Danielm102/SPARK/README.md

# SPARK
Stepper Power And Regulation Kit
