Danielm102/SPARK/KiCAD/Manufacturing/SPARK_BOM.xlsx

Reference | Qty | Value | Footprint
C1,C11,C23 | 3 | 100u | Capacitor_THT:CP_Radial_D5.0mm_P2.00mm
C2,C3,C7,C8,C9,C10 | 6 | 22u | Capacitor_SMD:C_1206_3216Metric
C4,C5,C6,C16,C18,C20 | 6 | 100n | Capacitor_SMD:C_0402_1005Metric
C12 | 1 | 220u | Capacitor_THT:CP_Radial_D6.3mm_P2.50mm
C13 | 1 | 2u2 | Capacitor_SMD:C_0402_1005Metric
C14 | 1 | 1n5 | Capacitor_SMD:C_0402_1005Metric
C15 | 1 | 12p | Capacitor_SMD:C_0402_1005Metric
C17 | 1 | 10u | Capacitor_SMD:C_0805_2012Metric
C19 | 1 | 220n | Capacitor_SMD:C_0402_1005Metric
C21,C22 | 2 | 10n | Capacitor_SMD:C_0402_1005Metric
C24 | 1 | 22n | Capacitor_SMD:C_0402_1005Metric
C25 | 1 | 1u | Capacitor_SMD:C_0603_1608Metric
J1,J2 | 2 | SM02B-GHS-TB | Connector_JST:JST_GH_SM02B-GHS-TB_1x02-1MP_P1.25mm_Horizontal
J3 | 1 | JST-XH-B4B | Connector_JST:JST_XH_B4B-XH-A_1x04_P2.50mm_Vertical
J4 | 1 | MicroFit | Connector_Molex:Molex_Micro-Fit_3.0_43045-0410_2x02-1MP_P3.00mm_Horizontal
J5 | 1 | SM06B-GHS-TB | Connector_JST:JST_GH_SM06B-GHS-TB_1x06-1MP_P1.25mm_Horizontal
J7,J8 | 2 | SM04B-GHS-TB | Connector_JST:JST_GH_SM04B-GHS-TB_1x04-1MP_P1.25mm_Horizontal
L1 | 1 | 2u2 | Library:L_13.5x12.8
LED1 | 1 | WS2812B | LED_SMD:LED_WS2812B_PLCC4_5.0x5.0mm_P3.2mm
LED2 | 1 | RED | LED_SMD:LED_0603_1608Metric
LED3 | 1 | YELLOW | LED_SMD:LED_0603_1608Metric
LED4,LED5 | 2 | GREEN | LED_SMD:LED_0603_1608Metric
LED6,LED7 | 2 | BLUE | LED_SMD:LED_0603_1608Metric
R1,R3 | 2 | 82k | Resistor_SMD:R_0402_1005Metric
R2 | 1 | 4k3 | Resistor_SMD:R_0402_1005Metric
R4,R5,R6,R14 | 4 | 10k | Resistor_SMD:R_0402_1005Metric
R7 | 1 | 2k2 | Resistor_SMD:R_0402_1005Metric
R8,R10,R11,R12,R13 | 5 | 1k | Resistor_SMD:R_0402_1005Metric
R9 | 1 | 4k7 | Resistor_SMD:R_0402_1005Metric
R15 | 1 | 14k7 | Resistor_SMD:R_0402_1005Metric
R16 | 1 | 2k8 | Resistor_SMD:R_0402_1005Metric
SW1 | 1 | SW_SPST | Button_Switch_SMD:Panasonic_EVQPUL_EVQPUC
TH1,TH2 | 2 | 10k | Resistor_SMD:R_0603_1608Metric
U1 | 1 | TPS61288RQQR | Package_DFN_QFN:Texas_VQFN-HR-20_3x2.5mm_P0.5mm_RQQ0011A
U2 | 1 | STM32G071KBT6 | Package_QFP:LQFP-32_7x7mm_P0.8mm
U3 | 1 | DRV8434S | Library:HTSSOP-28-1EP_4.4x9.7mm_P0.65mm_EP3.1x4.05mm_ThermalVias
