Danielm102/SPARK/KiCAD/SPARK_Schematic.pdf

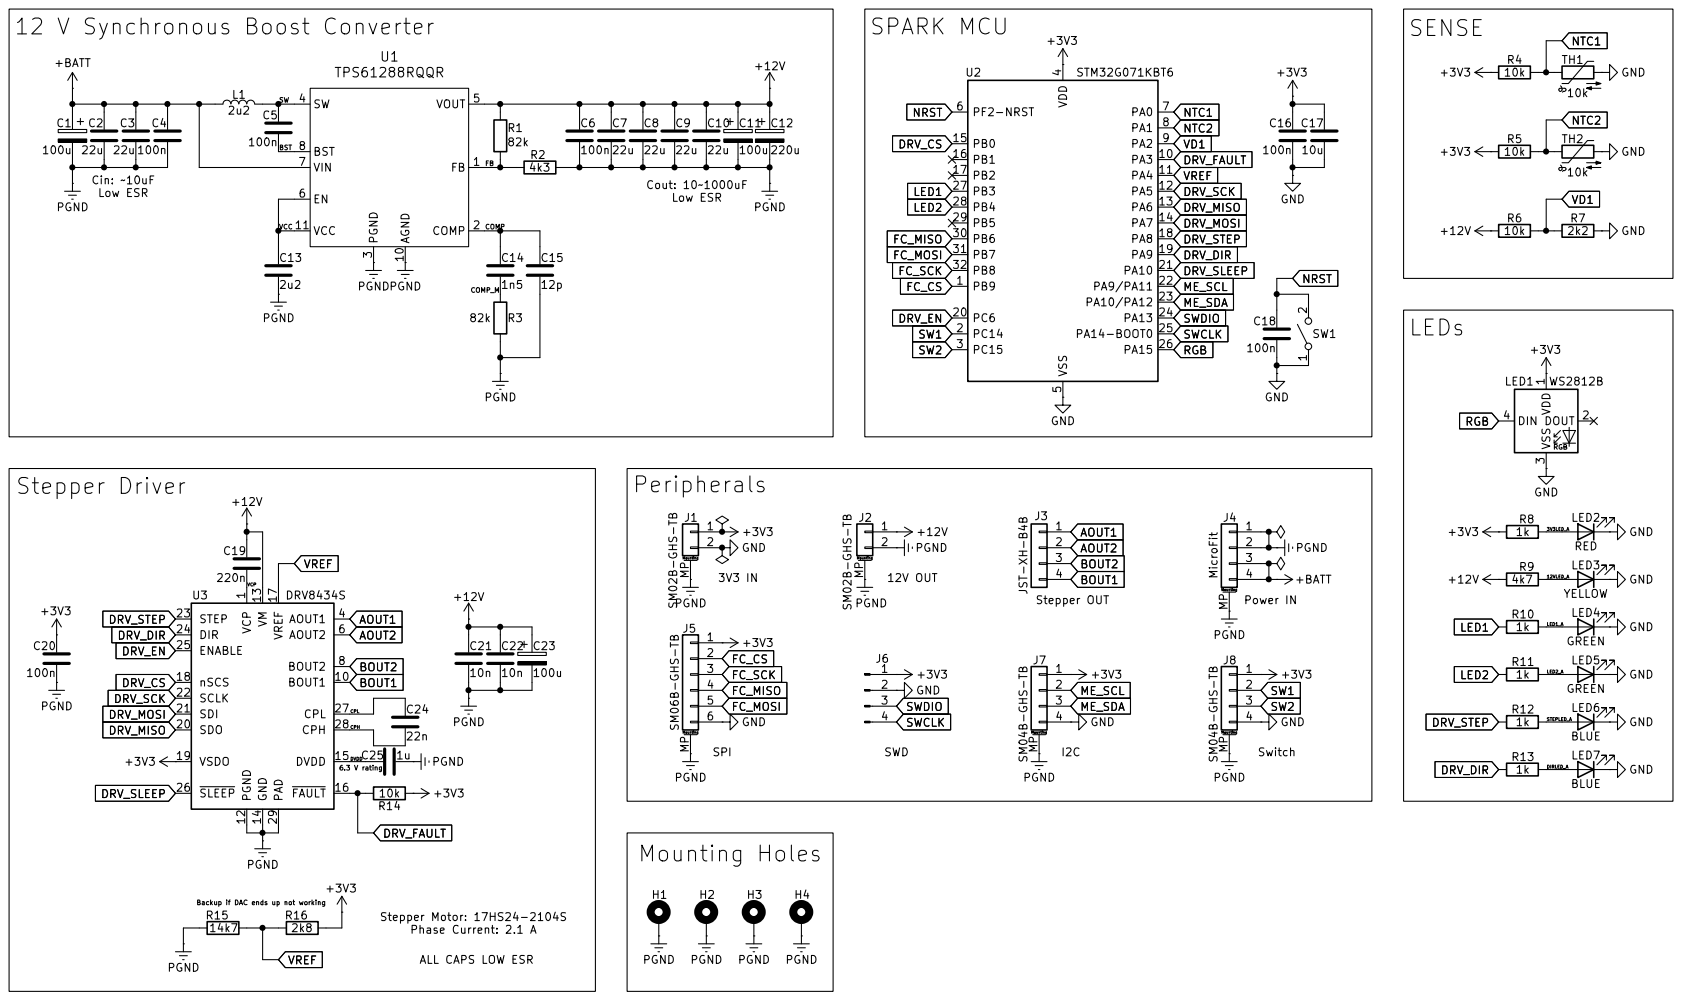
[picture p1: page 1]
