Danielm102/SPARK/KiCAD/SPARK.kicad_pcb

## KiCad design KiCAD/SPARK.kicad_pcb (2025-09-06)

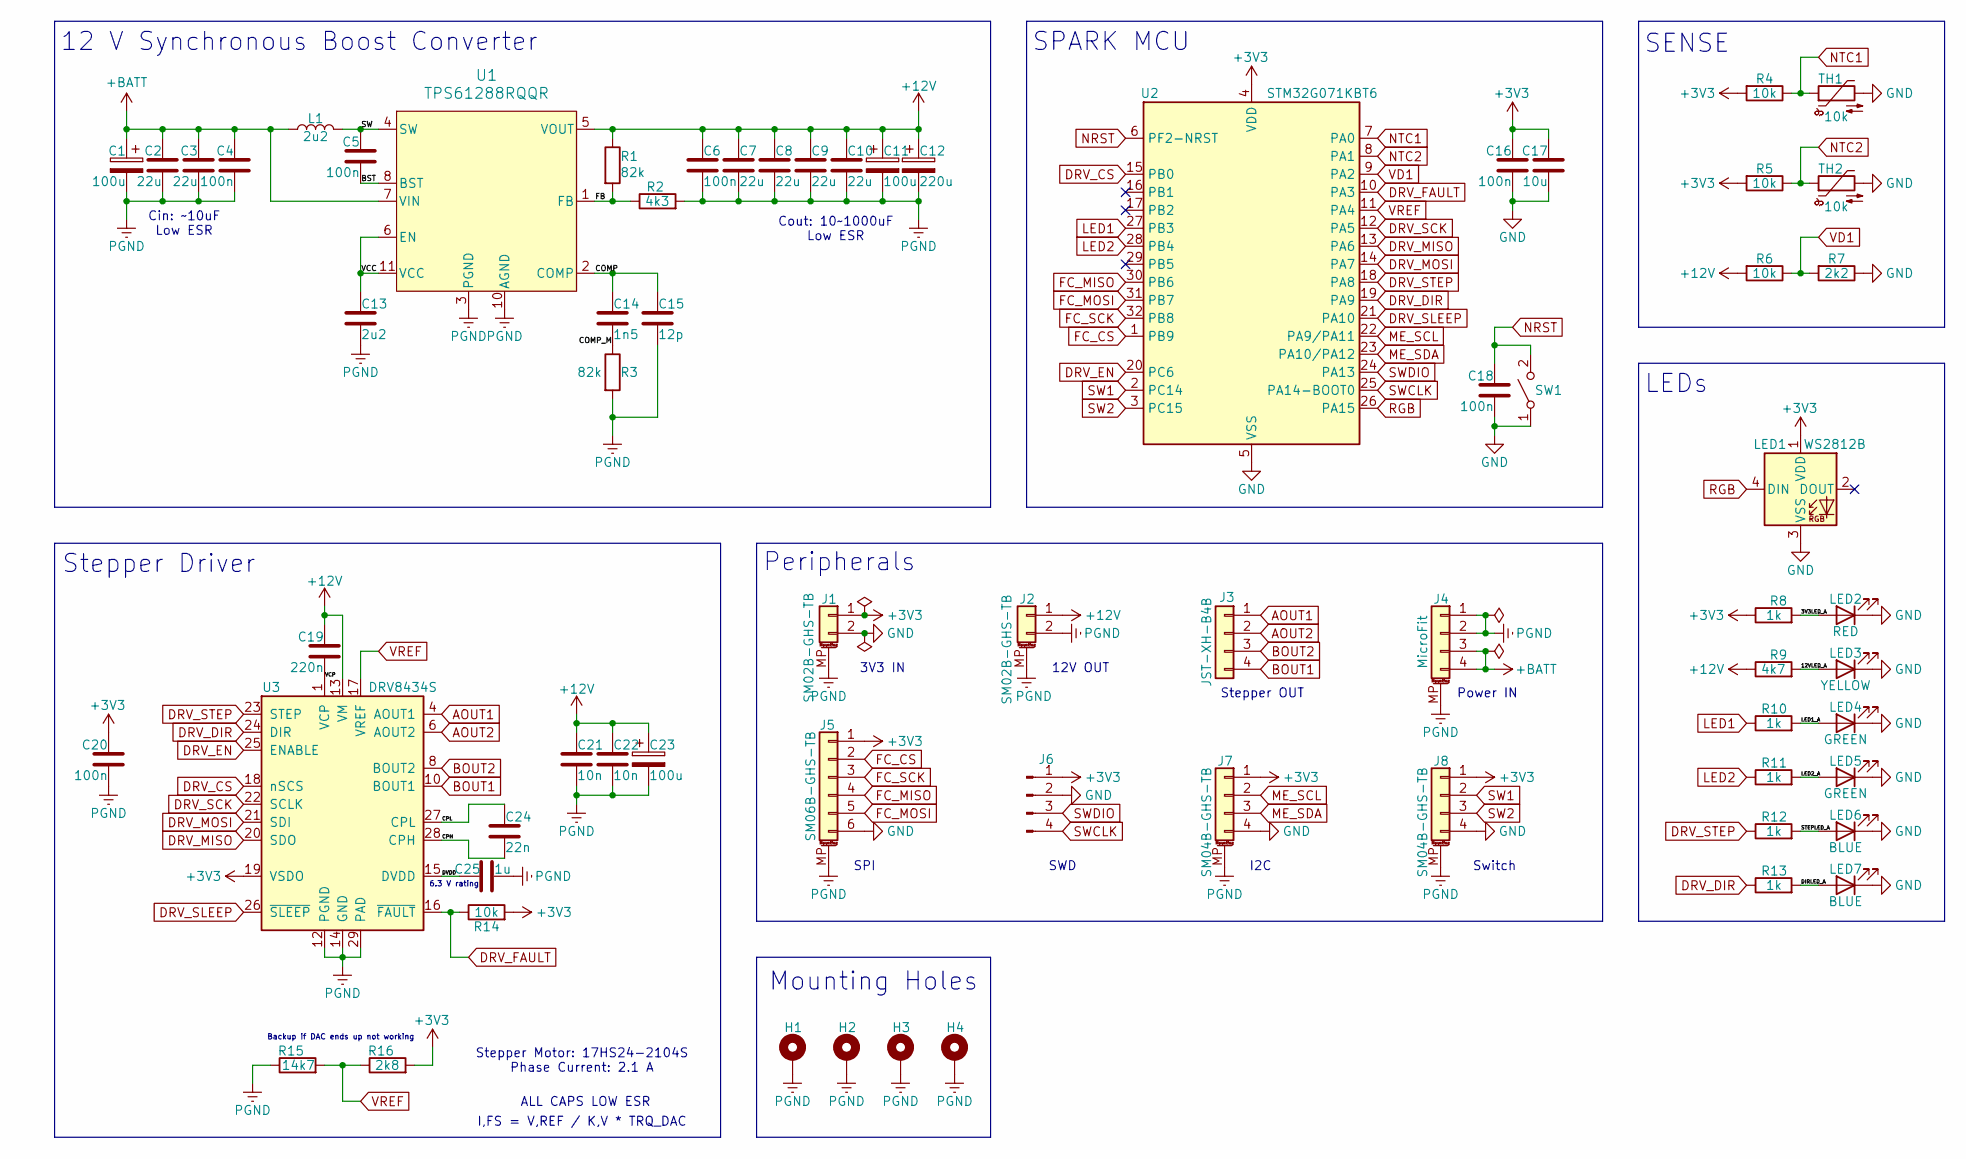
[picture p2: schematic SPARK.kicad_sch]

Parts:
C1, C11, C23: 100u; CP_Radial_D5.0mm_P2.00mm
C2, C3, C7, C8, C9, C10: 22u; C_1206_3216Metric
C4, C5, C6, C16, C18, C20: 100n; C_0402_1005Metric
C12: 220u; CP_Radial_D6.3mm_P2.50mm
C13: 2u2; C_0402_1005Metric
C14: 1n5; C_0402_1005Metric
C15: 12p; C_0402_1005Metric
C17: 10u; C_0805_2012Metric
C19: 220n; C_0402_1005Metric
C21, C22: 10n; C_0402_1005Metric
C24: 22n; C_0402_1005Metric
C25: 1u; C_0603_1608Metric
H1, H2, H3, H4: MountingHole_Pad; MountingHole_2.2mm_M2_Pad_Via
J1, J2: SM02B-GHS-TB; JST_GH_SM02B-GHS-TB_1x02-1MP_P1.25mm_Horizontal
J3: JST-XH-B4B; JST_XH_B4B-XH-A_1x04_P2.50mm_Vertical
J4: MicroFit; Molex_Micro-Fit_3.0_43045-0410_2x02-1MP_P3.00mm_Horizontal
J5: SM06B-GHS-TB; JST_GH_SM06B-GHS-TB_1x06-1MP_P1.25mm_Horizontal
J6: Conn_01x04_Pin; PinHeader_1x04_P2.54mm_Vertical
J7, J8: SM04B-GHS-TB; JST_GH_SM04B-GHS-TB_1x04-1MP_P1.25mm_Horizontal
L1: 2u2; L_13.5x12.8
LED1: WS2812B; LED_WS2812B_PLCC4_5.0x5.0mm_P3.2mm
LED2: RED; LED_0603_1608Metric
LED3: YELLOW; LED_0603_1608Metric
LED4, LED5: GREEN; LED_0603_1608Metric
LED6, LED7: BLUE; LED_0603_1608Metric
R1, R3: 82k; R_0402_1005Metric
R2: 4k3; R_0402_1005Metric
R4, R5, R6, R14: 10k; R_0402_1005Metric
R7: 2k2; R_0402_1005Metric
R8, R10, R11, R12, R13: 1k; R_0402_1005Metric
R9: 4k7; R_0402_1005Metric
R15: 14k7; R_0402_1005Metric
R16: 2k8; R_0402_1005Metric
SW1: SW_SPST; Panasonic_EVQPUL_EVQPUC
TH1, TH2: 10k; R_0603_1608Metric
U1: TPS61288RQQR; Texas_VQFN-HR-20_3x2.5mm_P0.5mm_RQQ0011A
U2: STM32G071KBT6; LQFP-32_7x7mm_P0.8mm
U3: DRV8434S; HTSSOP-28-1EP_4.4x9.7mm_P0.65mm_EP3.1x4.05mm_ThermalVias

Connections:
+3V3: C16.1, C17.1, C20.1, J1.1, J5.1, J6.1, J7.1, J8.1, LED1.1 (VDD), R4.2, R5.2, R8.1, R14.2, R16.2, U2.4 (VDD), U3.19 (VSDO)
+12V: C6.1, C7.1, C8.1, C9.1, C10.1, C11.1, C12.1, C19.1, C21.1, C22.1, C23.1, J2.1, R1.1, R6.2, R9.1, U1.5 (VOUT), U3.2 (VM), U3.13 (VM)
+BATT: C1.1, C2.1, C3.1, C4.1, J4.3, J4.4, L1.1, U1.7 (VIN)
/3V3LED_A: LED2.2 (A), R8.2
/12VLED_A: LED3.2 (A), R9.2
/BST: C5.2, U1.8 (BST)
/COMP: C14.1, C15.1, U1.2 (COMP)
/COMP_M: C14.2, R3.1
/CPH: C24.2, U3.28 (CPH)
/CPL: C24.1, U3.27 (CPL)
/DIRLED_A: LED7.2 (A), R13.2
/DVDD: C25.1, U3.15 (DVDD)
/FB: R1.2, R2.1, U1.1 (FB)
/LED1_A: LED4.2 (A), R10.2
/LED2_A: LED5.2 (A), R11.2
/STEPLED_A: LED6.2 (A), R12.2
/SW: C5.1, L1.2, U1.4 (SW), U1.9 (SW)
/VCC: C13.1, U1.6 (EN), U1.11 (VCC)
/VCP: C19.2, U3.1 (VCP)
AOUT1: J3.1, U3.4 (AOUT1), U3.5 (AOUT1)
AOUT2: J3.2, U3.6 (AOUT2), U3.7 (AOUT2)
BOUT1: J3.4, U3.10 (BOUT1), U3.11 (BOUT1)
BOUT2: J3.3, U3.8 (BOUT2), U3.9 (BOUT2)
DRV_CS: U2.15 (PB0), U3.18 (nSCS)
DRV_DIR: R13.1, U2.19 (PA9), U3.24 (DIR)
DRV_EN: U2.20 (PC6), U3.25 (ENABLE)
DRV_FAULT: R14.1, U2.10 (PA3), U3.16 (~FAULT)
DRV_MISO: U2.13 (PA6), U3.20 (SDO)
DRV_MOSI: U2.14 (PA7), U3.21 (SDI)
DRV_SCK: U2.12 (PA5), U3.22 (SCLK)
DRV_SLEEP: U2.21 (PA10), U3.26 (~SLEEP)
DRV_STEP: R12.1, U2.18 (PA8), U3.23 (STEP)
FC_CS: J5.2, U2.1 (PB9)
FC_MISO: J5.4, U2.30 (PB6)
FC_MOSI: J5.5, U2.31 (PB7)
FC_SCK: J5.3, U2.32 (PB8)
GND: C16.2, C17.2, C18.2, J1.2, J5.6, J6.2, J7.4, J8.4, LED1.3 (VSS), LED2.1 (K), LED3.1 (K), LED4.1 (K), LED5.1 (K), LED6.1 (K), LED7.1 (K), R7.1, SW1.1 (A), TH1.2, TH2.2, U2.5 (VSS)
LED1: R10.1, U2.27 (PB3)
LED2: R11.1, U2.28 (PB4)
ME_SCL: J7.2, U2.22 (PA9/PA11)
ME_SDA: J7.3, U2.23 (PA10/PA12)
NRST: C18.1, SW1.2 (B), U2.6 (PF2-NRST)
NTC1: R4.1, TH1.1, U2.7 (PA0)
NTC2: R5.1, TH2.1, U2.8 (PA1)
PGND: C1.2, C2.2, C3.2, C4.2, C6.2, C7.2, C8.2, C9.2, C10.2, C11.2, C12.2, C13.2, C15.2, C20.2, C21.2, C22.2, C23.2, C25.2, H1.1, H2.1, H3.1, H4.1, J1.MP (MountPin), J2.2, J2.MP (MountPin), J4.1, J4.2, J4.MP (MountPin), J5.MP (MountPin), J7.MP (MountPin), J8.MP (MountPin), R2.2, R3.2, R15.1, U1.3 (PGND), U1.10 (AGND), U3.3 (PGND), U3.12 (PGND), U3.14 (GND), U3.29 (PAD)
RGB: LED1.4 (DIN), U2.26 (PA15)
SW1: J8.2, U2.2 (PC14)
SW2: J8.3, U2.3 (PC15)
SWCLK: J6.4, U2.25 (PA14-BOOT0)
SWDIO: J6.3, U2.24 (PA13)
VD1: R6.1, R7.2, U2.9 (PA2)
VREF: R15.2, R16.1, U2.11 (PA4), U3.17 (VREF)

Notes on the sheet:
Peripherals
ALL CAPS LOW ESR
Stepper OUT
Mounting Holes
I,FS = V,REF / K,V * TRQ_DAC
3V3 IN
Power IN
I2C
SENSE
12V OUT
Cin: ~10uF Low ESR
SPI
SWD
SPARK MCU
Stepper Driver
LEDs
6.3 V rating
Stepper Motor: 17HS24-2104S Phase Current: 2.1 A
12 V Synchronous Boost Converter
Cout: 10~1000uF Low ESR
Switch
Backup if DAC ends up not working

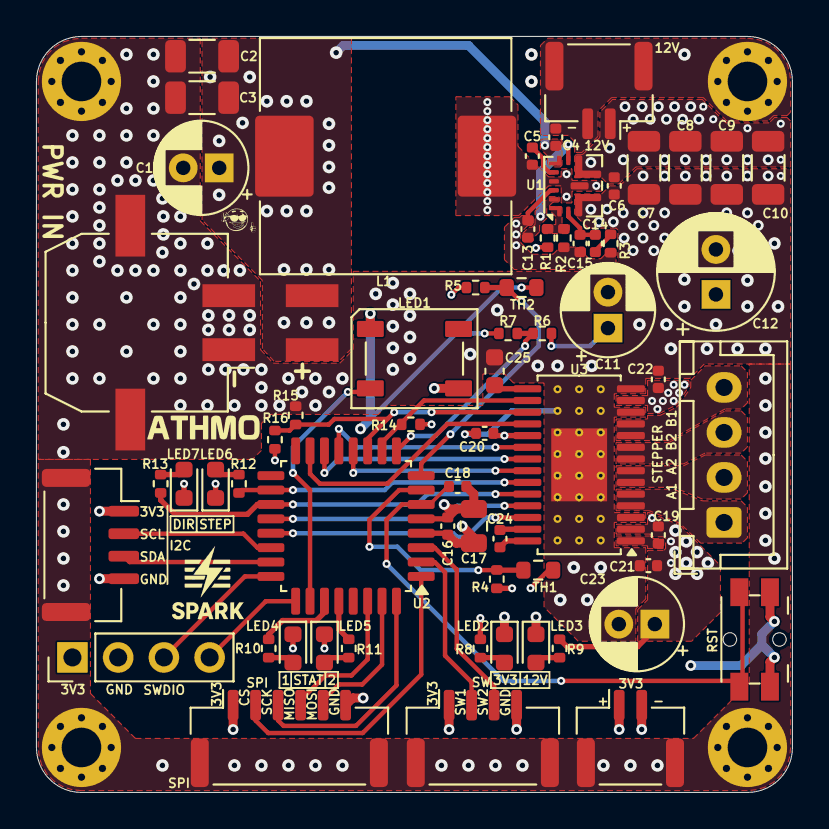
[picture p3: board SPARK.kicad_pcb from above]

Board: 4 copper layers, 42.0 x 42.0 mm, 67 parts (0 on the bottom side), 52 nets.
