Danielm102/SPARK/Core/Src/main.c

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
/* Includes ------------------------------------------------------------------*/
#include "main.h"

ADC_HandleTypeDef hadc1;

DAC_HandleTypeDef hdac1;

I2C_HandleTypeDef hi2c2;

SPI_HandleTypeDef hspi1;
SPI_HandleTypeDef hspi2;

TIM_HandleTypeDef htim1;
TIM_HandleTypeDef htim2;
TIM_HandleTypeDef htim3;
TIM_HandleTypeDef htim7;
DMA_HandleTypeDef hdma_tim1_ch1;
DMA_HandleTypeDef hdma_tim2_ch1;

/* USER CODE BEGIN PV */
volatile uint32_t tim7_ms = 0;
uint32_t tim7_target_ms;

uint16_t tick_ks = 0;
uint32_t tick_ms = 0;
uint32_t tick_us = 0;
uint32_t tick_raw = 0;
uint32_t tick_us_start = 0;
uint16_t overflow_count = 0;

uint32_t dt_100Hz;
uint32_t dt_10Hz;

uint32_t loop_counter_100Hz = 0;
uint32_t loop_counter_10Hz = 0;

volatile uint8_t dma_waiting_ws2812;

AS5600_status_t AS5600_status;

float voltage_driver;
float temperature_driver;
float temperature_converter;

float mag_angle = 0;
float mag_speed = 0;
float rotation_count = 0;
float mag_angle_continuous = 0;
float angle_cmd_prev = 0;
float angle_cmd_diff = 0;

/* USER CODE END PV */

void SystemClock_Config(void);
static void MX_GPIO_Init(void);
static void MX_DMA_Init(void);
static void MX_SPI1_Init(void);
static void MX_TIM1_Init(void);
static void MX_I2C2_Init(void);
static void MX_SPI2_Init(void);
static void MX_ADC1_Init(void);
static void MX_DAC1_Init(void);
static void MX_TIM2_Init(void);
static void MX_TIM3_Init(void);
static void MX_TIM7_Init(void);
/**
  * @brief  The application entry point.
  * @retval int
  */
int main(void)
{

  /* MCU Configuration--------------------------------------------------------*/

  /* Reset of all peripherals, Initializes the Flash interface and the Systick. */
  HAL_Init();

  /* Configure the system clock */
  SystemClock_Config();

  /* Initialize all configured peripherals */
  MX_GPIO_Init();
  MX_DMA_Init();
  MX_SPI1_Init();
  MX_TIM1_Init();
  MX_I2C2_Init();
  MX_SPI2_Init();
  MX_ADC1_Init();
  MX_DAC1_Init();
  MX_TIM2_Init();
  MX_TIM3_Init();
  MX_TIM7_Init();
  /* USER CODE BEGIN 2 */
  
  RunOnce();
  /* USER CODE END 2 */

  /* Infinite loop */
  /* USER CODE BEGIN WHILE */
  while (1)
  {
    HAL_GetTickUS();

    if(tick_us > 10000 * loop_counter_100Hz - TICK_US_RESET_THRESHOLD * tick_ks) {
      TimeMeasureStart();
      loop_counter_100Hz++;
      Loop_100Hz();
      dt_100Hz = TimeMeasureStop();
    }
    
    if(tick_us > 100000 * loop_counter_10Hz - TICK_US_RESET_THRESHOLD * tick_ks) {
      TimeMeasureStart();
      loop_counter_10Hz++;
      Loop_10Hz();
      dt_10Hz = TimeMeasureStop();
    }
  }
  /* USER CODE END 3 */
}

void RunOnce() 
{
  Stepper_Sleep();
  HAL_Delay(100);
  StateMachine_Init(&spark_sm, STATE_STARTUP);

  AS5600_readAngle(&mag_angle_continuous);

  Communication_ActivateReceive();

  angle_cmd_prev = stepper.pos_cmd;
}

void Loop_100Hz()
{
  AS5600_readAngle(&mag_angle);
  AngleConstrainedToContinuous(mag_angle, &mag_angle_continuous, &rotation_count);

  mag_speed = (mag_angle_continuous - stepper.pos_prev) * 100.f;
  angle_cmd_diff = ((stepper.pos_cmd - angle_cmd_prev) * 100.f) * 0.1f + angle_cmd_diff * 0.9f;
  angle_cmd_prev = stepper.pos_cmd;

  StateMachine_DoActions(&spark_sm, 100);
  Stepper_getFullStatus();
  if (DRV_status.FAULT) {
    Stepper_clearFaults();
  }
  Stepper_updateSpeed(100, mag_angle_continuous);

  ShowStatus(RGB_LED, spark_sm.currentState, 1, 100);
}

void Loop_10Hz()
{ 
  temperature_driver = readTemperature(ADC_CHANNEL_0);
  temperature_converter = readTemperature(ADC_CHANNEL_1);
  voltage_driver = readVoltage(ADC_CHANNEL_2) * 12.2f / 2.2f;

  StateMachine_DoActions(&spark_sm, 10);

  AS5600_getStatus(&AS5600_status);
}

void HAL_GPIO_EXTI_Rising_Callback(uint16_t GPIO_Pin) {
  // handle DRV8434S fault release
  if(GPIO_Pin == DRV_FAULT_Pin) {
    HAL_GPIO_WritePin(LED2_GPIO_Port, LED2_Pin, GPIO_PIN_SET);
  }
}

void HAL_GPIO_EXTI_Falling_Callback(uint16_t GPIO_Pin) {
  // handle DRV8434S fault detection
  if(GPIO_Pin == DRV_FAULT_Pin) {
    HAL_GPIO_WritePin(LED2_GPIO_Port, LED2_Pin, GPIO_PIN_RESET);

    Stepper_getFullStatus();

    if (DRV_status.STL) {
      stepper.stall_count++;
      StateMachine_Dispatch(&spark_sm, EVENT_STEPPER_STALLED);
    }
    if (DRV_status.UVLO) StateMachine_Dispatch(&spark_sm, EVENT_UVLO);
    if (DRV_status.TF) StateMachine_Dispatch(&spark_sm, EVENT_DRIVER_OVERHEAT);
  } else if(GPIO_Pin == FC_CS_Pin) {
    // handle falling edge of SPI1 chip select - start of new command packet
    //Communication_ActivateReceive();
  }
}

void HAL_SPI_TxRxCpltCallback(SPI_HandleTypeDef *hspi) {
  if(hspi->Instance == SPI2) {
    // Process received data
    ProcessCommandPacket();
    UpdateSPARKDataPacket(&spark_data_packet, mag_angle_continuous - stepper.neutral_angle, angle_cmd_diff, mag_angle_continuous - stepper.pos_cmd, voltage_driver, temperature_driver, temperature_converter, (uint8_t)spark_sm.currentState);
    spi2_tx_buffer[31] = getCRC(&spark_data_packet);
    Communication_ActivateReceive();
  }
}

void HAL_SPI_ErrorCallback(SPI_HandleTypeDef *hspi) {
  if(hspi->Instance == SPI2) {
    // Handle SPI error
    Communication_ActivateReceive();
  }
}

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
/* USER CODE BEGIN 4 */
void HAL_TIM_PWM_PulseFinishedCallback(TIM_HandleTypeDef *htim)
{
  if (htim->Instance == TIM1 && htim->Channel == HAL_TIM_ACTIVE_CHANNEL_1) {
    HAL_TIM_PWM_Stop_DMA(&htim1, TIM_CHANNEL_1);
    Stepper_Disable();
  }
  if (htim->Instance == TIM2 && htim->Channel == HAL_TIM_ACTIVE_CHANNEL_1) {
    HAL_TIM_PWM_Stop_DMA(&htim2, TIM_CHANNEL_1);
    dma_waiting_ws2812 = 0;
    led_skip_counter = 0;
  }
}

void HAL_TIM_PeriodElapsedCallback(TIM_HandleTypeDef *htim)
{
  if (htim->Instance == TIM1 && htim->Channel == HAL_TIM_ACTIVE_CHANNEL_1) {
    // PWM burst finished
    HAL_TIM_PWM_Stop(htim, TIM_CHANNEL_1);
  }
  else if (htim->Instance == TIM7) {
    tim7_ms++;
    if (tim7_ms >= tim7_target_ms) {
      tim7_ms = 0;
      HAL_TIM_Base_Stop_IT(&htim7);
      
      StateMachine_Dispatch(&spark_sm, EVENT_TIMER_ELAPSED);
    }
  }
}

uint32_t HAL_GetTickUS(void) {
  uint32_t tick_now = TIM3->CNT;
  if (tick_now < tick_raw)
    overflow_count++;

  tick_raw = tick_now;
  tick_us = tick_raw + overflow_count * 65536;
  if (tick_us > TICK_US_RESET_THRESHOLD) {
    tick_ks++;
    overflow_count = 0;
  }

  return tick_us; // get the current value of TIM3 counter
}

void TimeMeasureStart(void) {
  tick_us_start = HAL_GetTickUS();
}

uint32_t TimeMeasureStop(void) {
  int32_t time_diff = HAL_GetTickUS() - tick_us_start;
  if (time_diff < 0)
    time_diff += TICK_US_RESET_THRESHOLD;
  return time_diff;
}
/* USER CODE END 4 */
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
