Danielm102/SPARK/SPARK.ioc

Mcu.UserName=STM32G071KBTx
PA0.GPIO_Label=NTC1
PA0.Signal=ADC1_IN0
PA1.GPIO_Label=NTC2
PA1.Signal=ADC1_IN1
PA10.GPIO_Label=DRV_SLEEP
PA10.Signal=GPIO_Output
PA13.Signal=SYS_SWDIO
PA14-BOOT0.Signal=SYS_SWCLK
PA15.GPIO_Label=RGB
PA15.Signal=S_TIM2_CH1_ETR
PA2.GPIO_Label=VD1
PA2.Signal=ADC1_IN2
PA3.GPIO_Label=DRV_FAULT
PA3.Signal=GPXTI3
PA4.GPIO_Label=DRV_VREF
PA4.Signal=COMP_DAC11_group
PA5.Signal=SPI1_SCK
PA6.Signal=SPI1_MISO
PA7.Signal=SPI1_MOSI
PA8.GPIO_Label=DRV_STEP
PA8.Signal=S_TIM1_CH1
PA9.GPIO_Label=DRV_DIR
PA9.Signal=GPIO_Output
PB0.GPIO_Label=DRV_CS
PB0.Signal=GPIO_Output
PB3.GPIO_Label=LED1
PB3.Signal=GPIO_Output
PB4.GPIO_Label=LED2
PB4.Signal=GPIO_Output
PB6.GPIO_Label=FC_MISO
PB6.Signal=SPI2_MISO
PB7.GPIO_Label=FC_MOSI
PB7.Signal=SPI2_MOSI
PB8.GPIO_Label=FC_SCK
PB8.Signal=SPI2_SCK
PB9.GPIO_Label=FC_CS
PB9.Signal=GPXTI9
PC6.GPIO_Label=DRV_EN
PC6.Signal=GPIO_Output
