Danielm102/SPARK/Core/Inc/main.h

#define FC_CS_Pin GPIO_PIN_9
#define FC_CS_GPIO_Port GPIOB
#define FC_CS_EXTI_IRQn EXTI4_15_IRQn
#define SW1_Pin GPIO_PIN_14
#define SW1_GPIO_Port GPIOC
#define SW1_EXTI_IRQn EXTI4_15_IRQn
#define SW2_Pin GPIO_PIN_15
#define SW2_GPIO_Port GPIOC
#define SW2_EXTI_IRQn EXTI4_15_IRQn
#define NTC1_Pin GPIO_PIN_0
#define NTC1_GPIO_Port GPIOA
#define NTC2_Pin GPIO_PIN_1
#define NTC2_GPIO_Port GPIOA
#define VD1_Pin GPIO_PIN_2
#define VD1_GPIO_Port GPIOA
#define DRV_FAULT_Pin GPIO_PIN_3
#define DRV_FAULT_GPIO_Port GPIOA
#define DRV_FAULT_EXTI_IRQn EXTI2_3_IRQn
#define DRV_VREF_Pin GPIO_PIN_4
#define DRV_VREF_GPIO_Port GPIOA
#define DRV_CS_Pin GPIO_PIN_0
#define DRV_CS_GPIO_Port GPIOB
#define DRV_STEP_Pin GPIO_PIN_8
#define DRV_STEP_GPIO_Port GPIOA
#define DRV_DIR_Pin GPIO_PIN_9
#define DRV_DIR_GPIO_Port GPIOA
#define DRV_EN_Pin GPIO_PIN_6
#define DRV_EN_GPIO_Port GPIOC
#define DRV_SLEEP_Pin GPIO_PIN_10
#define DRV_SLEEP_GPIO_Port GPIOA
#define RGB_Pin GPIO_PIN_15
#define RGB_GPIO_Port GPIOA
#define LED1_Pin GPIO_PIN_3
#define LED1_GPIO_Port GPIOB
#define LED2_Pin GPIO_PIN_4
#define LED2_GPIO_Port GPIOB
#define FC_MISO_Pin GPIO_PIN_6
#define FC_MISO_GPIO_Port GPIOB
#define FC_MOSI_Pin GPIO_PIN_7
#define FC_MOSI_GPIO_Port GPIOB
#define FC_SCK_Pin GPIO_PIN_8
#define FC_SCK_GPIO_Port GPIOB
#define TICK_US_RESET_THRESHOLD 1000000000
