Danielm102/SPARK/(commit log)

2025-09-06 Code generated
    [SPARK-B_Cu.gbr, SPARK-B_Mask.gbr, SPARK-B_Paste.gbr, SPARK-B_Silkscreen.gbr, SPARK-Edge_Cuts.gbr, SPARK-F_Cu.gbr, SPARK-F_Mask.gbr, SPARK-F_Paste.gbr]
2025-09-06 RGB LED + status library
2025-09-07 DRV8434S SPI library added
    Prototype. Most functions not yet tested.
2025-09-08 Stepper init and pwm burst function added
2025-09-08 Loops added
    10 Hz, 100 Hz & 1000 Hz
2025-09-10 Stepper homing sequence
2025-09-11 Timer small frequency bug fixed
    [AS5600.c, Stepper.c, Stepper.h, main.c]
2025-09-12 Stepper stall learning sequence
    [Stepper.c, Stepper.h, main.c]
2025-09-12 Homing sequence working
2025-09-15 Homing sequence improved
2025-11-05 Fixed startup issue.
    Fixed issue where Stepper_init(); was called while ACS disarmed, which caused the microstepping settings resetting after arming
    [Stepper.c, main.c]
2025-11-05 Fixed fault clearing loops.
    Fixed issue where fault pin would rise immediately after clearing a fault, causing another clear, resulting in the microcontroller being stuck
    [Stepper.c]
2025-11-09 Fixed accidental rotation count during startup
    Just so the rotation count variable makes sense
    [main.c]
2025-11-10 Fixed RGB LED
